kazuyahirotsu/LoRa/README.md

# LoRa
This repository is a collection of codes that I used for my thesis project.  
For more information, read [this documentation](https://docs.google.com/document/d/1nxEVbDSikG9Jm16irHsT5aI4RiOQiIEvlL14KSLo8pY/edit?usp=sharing)
