kazuyahirotsu/LoRa/project/README.md

## esp32

This folder contains ino files for esp32. 
you might need to add some libraries to use them on Arduino app

## GPS-visualization-Python

This folder contains python scripts for visualizing csv files of the tests with raspberrypi 

## izunuma_analysis

This folder contains codes for analysis of izunuma deployment

## matlab

This folder contains matlab scripts for simulating LoRa and mpsk

## network_simulation

This folder contains python scripts for simulating custom mac layer protocols

## raspberrypi

This folder contains python scripts for base node operation and test with raspberrypi

## relay

This folder contains python scripts for basic simulation of relay

## solar

This folder contains python scripts for testing a solar panel and a battery with raspberrypi

## weather

This folder contains python scripts for simulating battery life in certain place
