kazuyahirotsu/LoRa/project/GPS-visualization-Python/map/map0.png

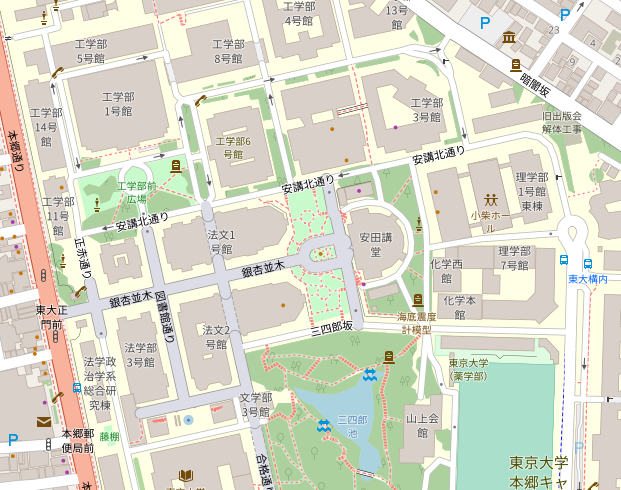
project/GPS-visualization-Python/map/map0.png
