kazuyahirotsu/LoRa/project/GPS-visualization-Python/map/map_big_izunuma.png

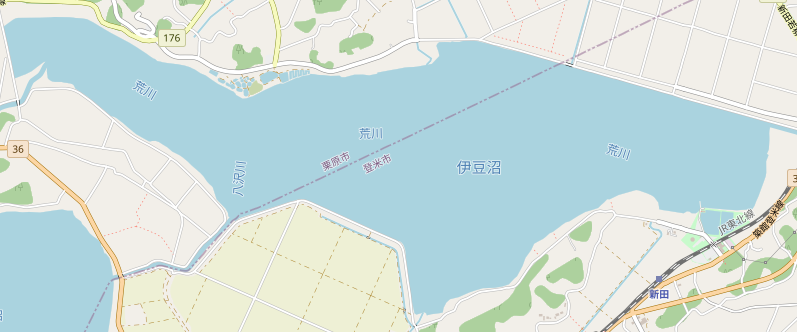
project/GPS-visualization-Python/map/map_big_izunuma.png
