kazuyahirotsu/LoRa/project/GPS-visualization-Python/map/map_small_izunuma.png

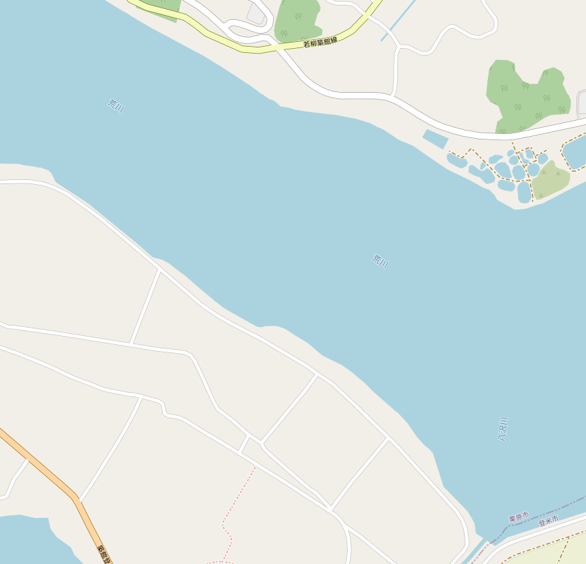
project/GPS-visualization-Python/map/map_small_izunuma.png
