kazuyahirotsu/LoRa/project/GPS-visualization-Python/map/map_toyosu.png

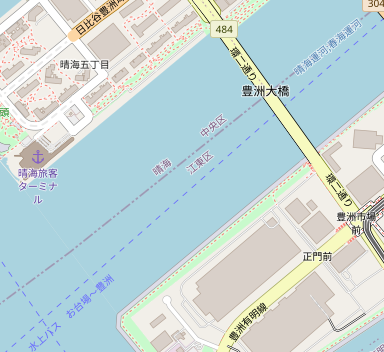
project/GPS-visualization-Python/map/map_toyosu.png
