kazuyahirotsu/LoRa/project/GPS-visualization-Python/output.png

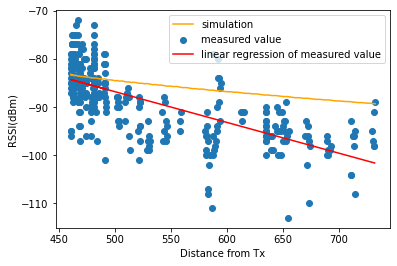
project/GPS-visualization-Python/output.png
