kazuyahirotsu/LoRa/project/GPS-visualization-Python/plot_small_izunuma.png

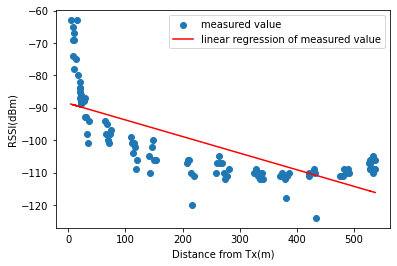
project/GPS-visualization-Python/plot_small_izunuma.png
