kazuyahirotsu/LoRa/project/matlab/LoRa/justnoise_ser_bigtest.png

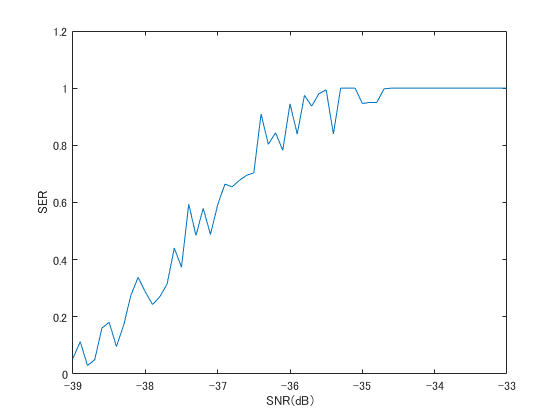
project/matlab/LoRa/justnoise_ser_bigtest.png
