kazuyahirotsu/LoRa/project/matlab/LoRa/multipath_ser_bigtest.png

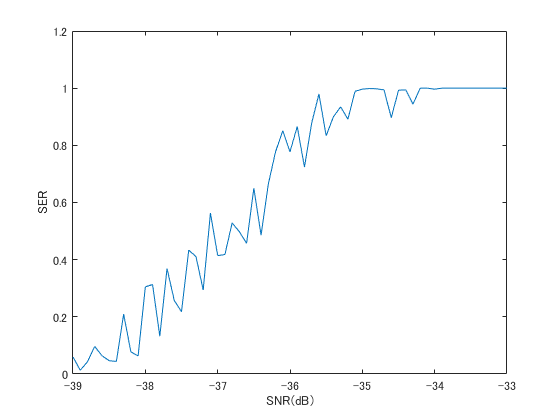
project/matlab/LoRa/multipath_ser_bigtest.png
