kazuyahirotsu/LoRa/project/matlab/psk/bpsk_ser_bigtest.png

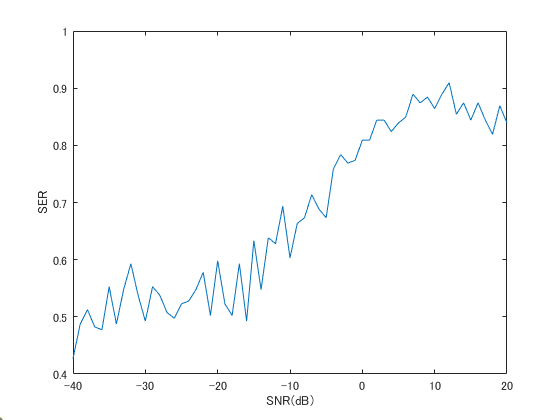
project/matlab/psk/bpsk_ser_bigtest.png
