kazuyahirotsu/LoRa/project/matlab/psk/qpsk_ser_bigtest.png

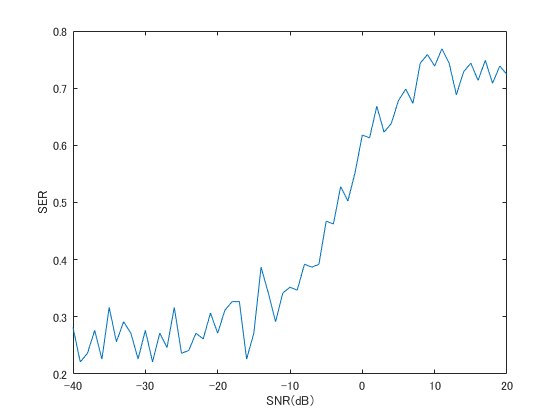
project/matlab/psk/qpsk_ser_bigtest.png
