kazuyahirotsu/LoRa/project/solar/output.png

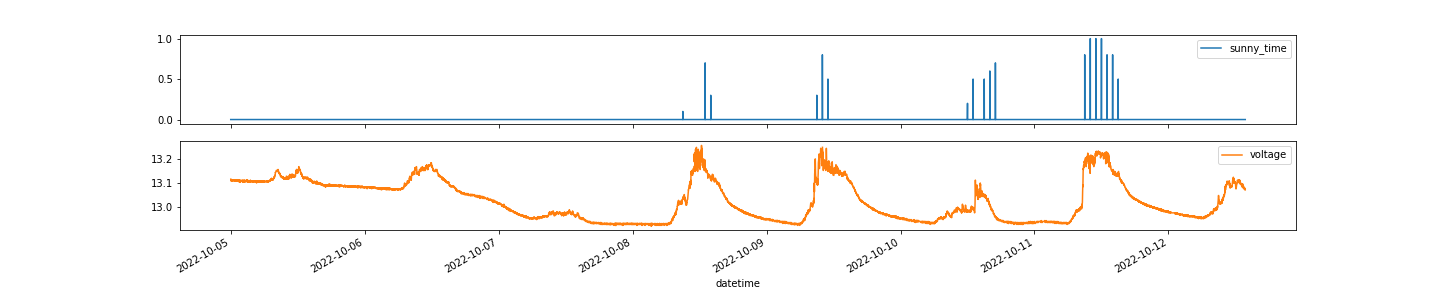
project/solar/output.png
