kazuyahirotsu/LoRa/project/weather/backtest.png

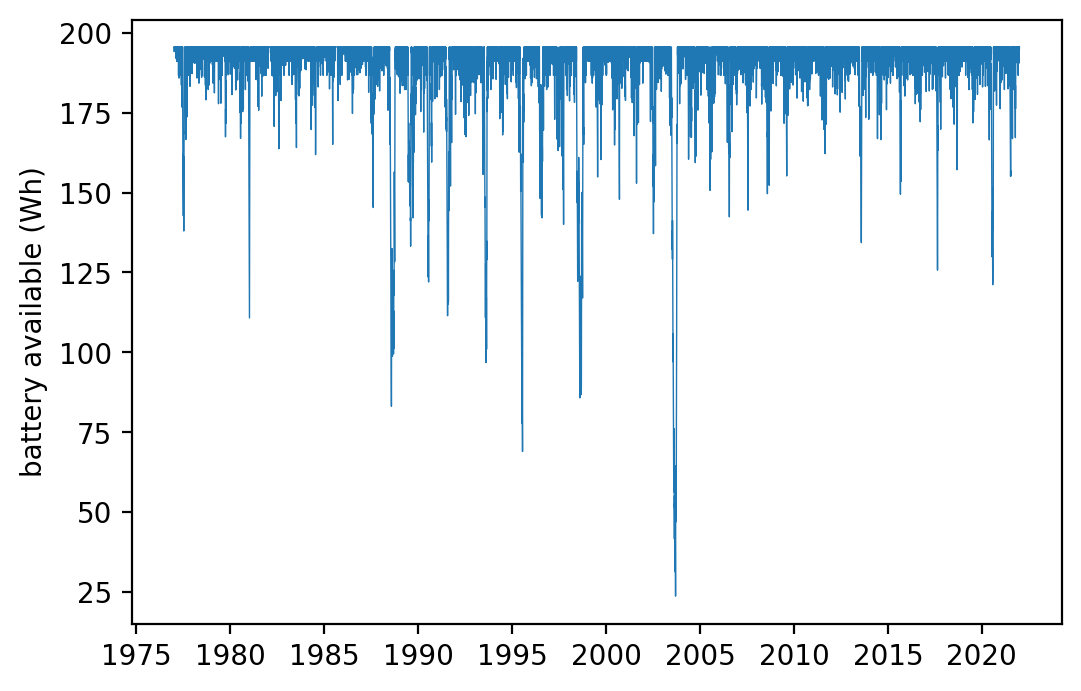
project/weather/backtest.png
