kazuyahirotsu/LoRa/project/weather/sunshine_duration.png

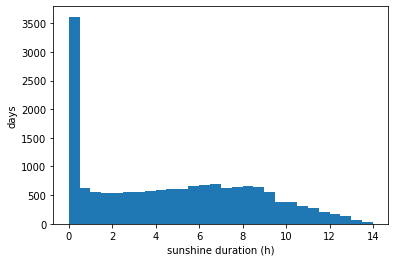
project/weather/sunshine_duration.png
