kazuyahirotsu/LoRa/project/GPS-visualization-Python/reslutMap/resultMap_5_10.png

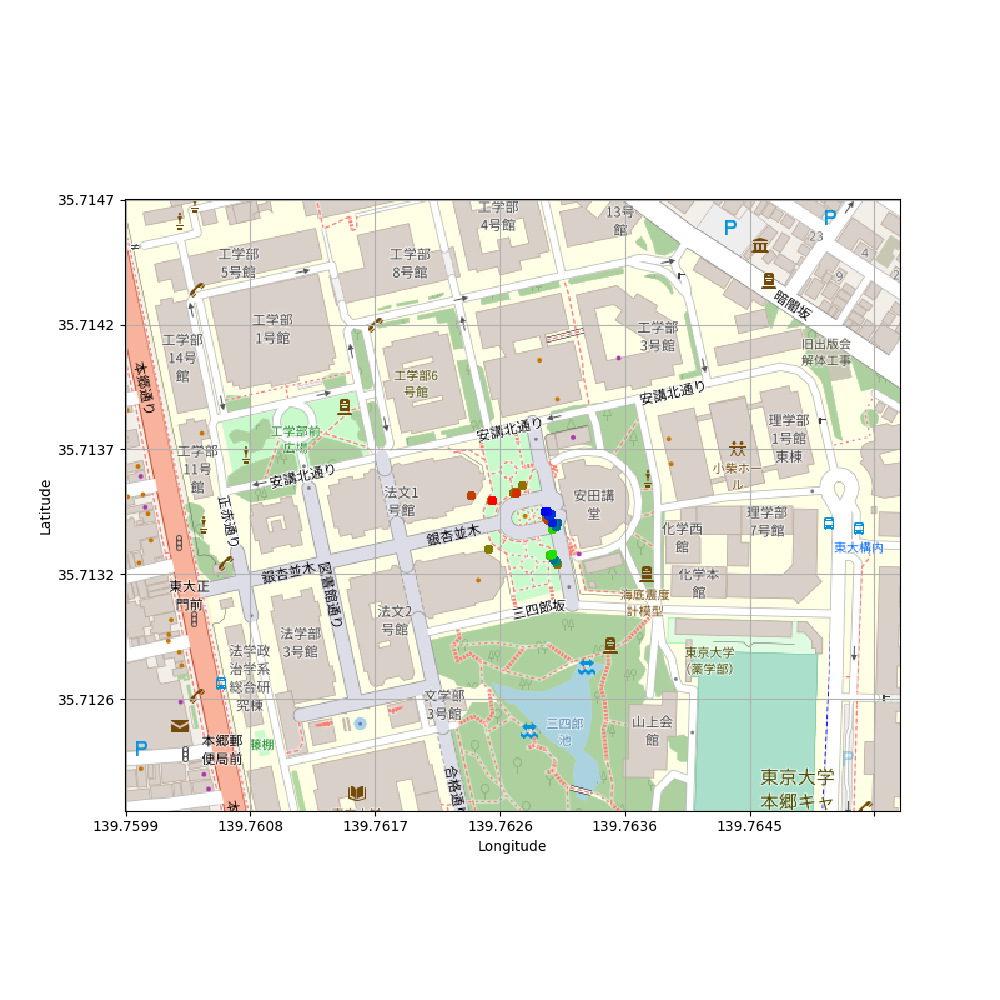
project/GPS-visualization-Python/reslutMap/resultMap_5_10.png
