kazuyahirotsu/LoRa/project/GPS-visualization-Python/reslutMap/resultMap_5_15.png

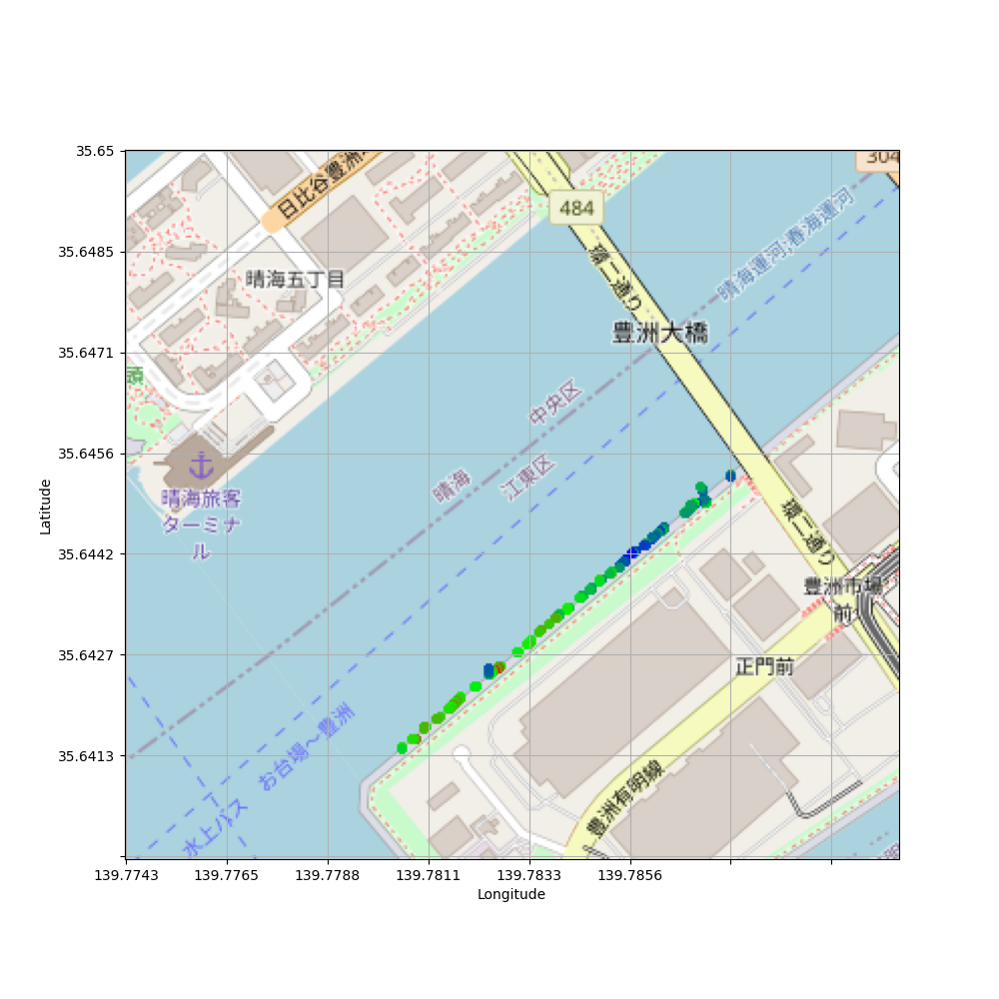
project/GPS-visualization-Python/reslutMap/resultMap_5_15.png
