kazuyahirotsu/LoRa/project/GPS-visualization-Python/reslutMap/resultMap_big_izunuma.png

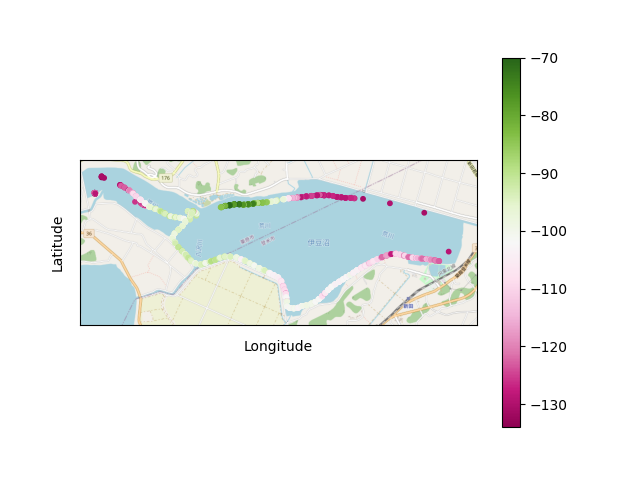
project/GPS-visualization-Python/reslutMap/resultMap_big_izunuma.png
