kazuyahirotsu/LoRa/project/GPS-visualization-Python/reslutMap/resultMap_small_izunuma.png

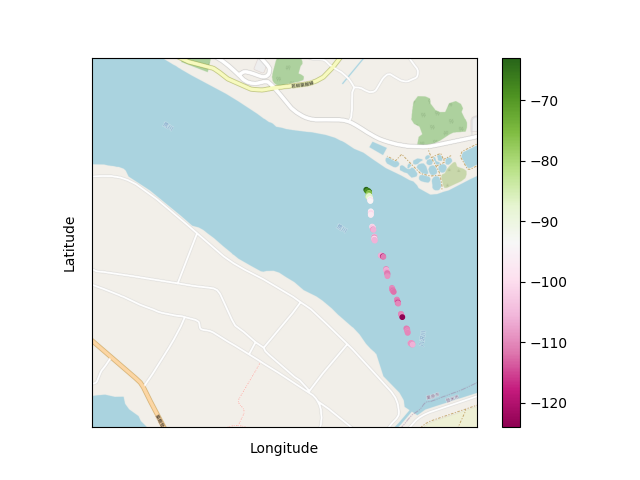
project/GPS-visualization-Python/reslutMap/resultMap_small_izunuma.png
