kazuyahirotsu/LoRa/project/GPS-visualization-Python/reslutMap/resultMap_toyosu.png

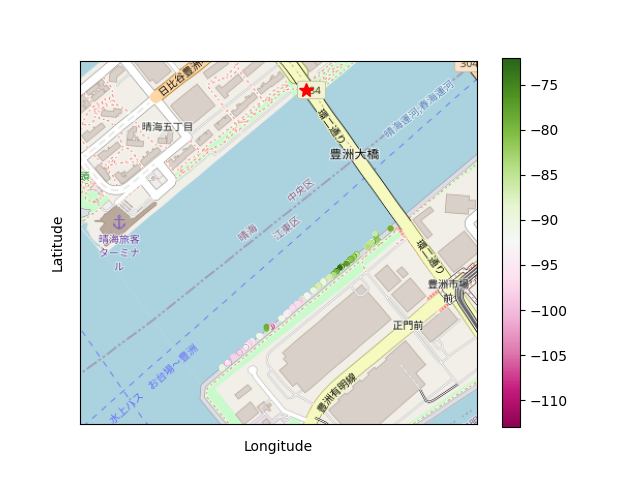
project/GPS-visualization-Python/reslutMap/resultMap_toyosu.png
