kazuyahirotsu/LoRa/project/izunuma_analysis/result0001.png

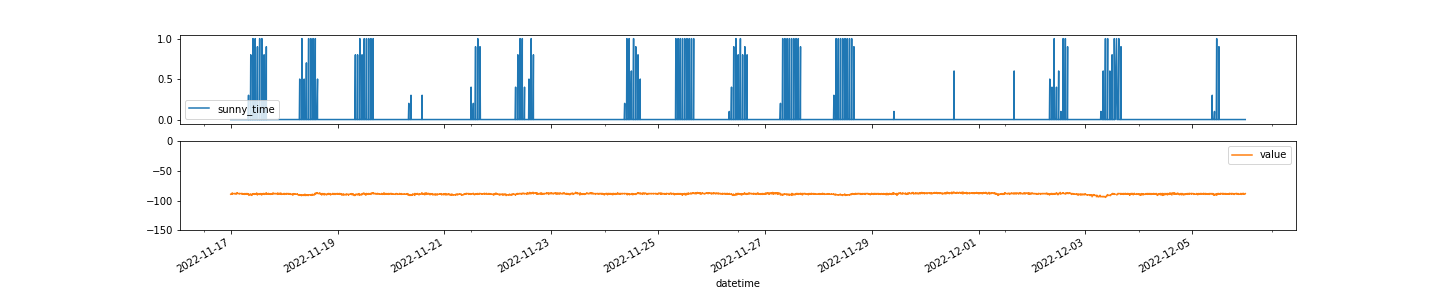
project/izunuma_analysis/result0001.png
