kazuyahirotsu/LoRa/project/izunuma_analysis/result0002.png

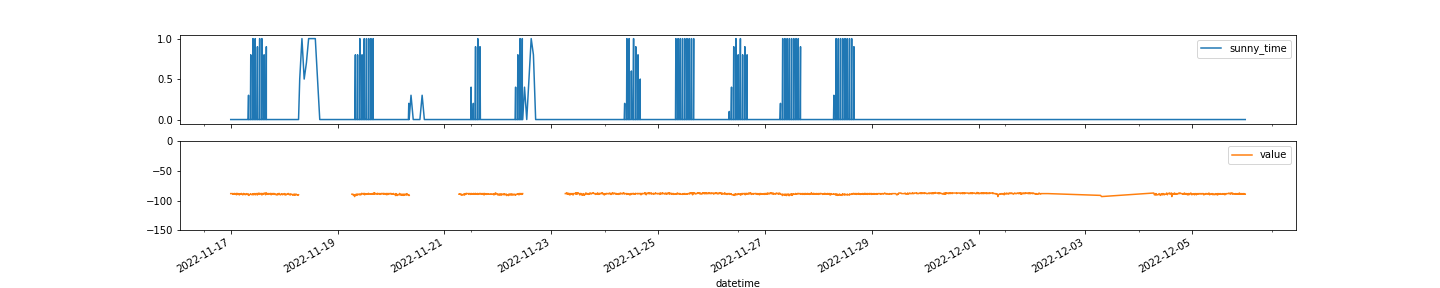
project/izunuma_analysis/result0002.png
