kazuyahirotsu/LoRa/project/izunuma_analysis/result0003.png

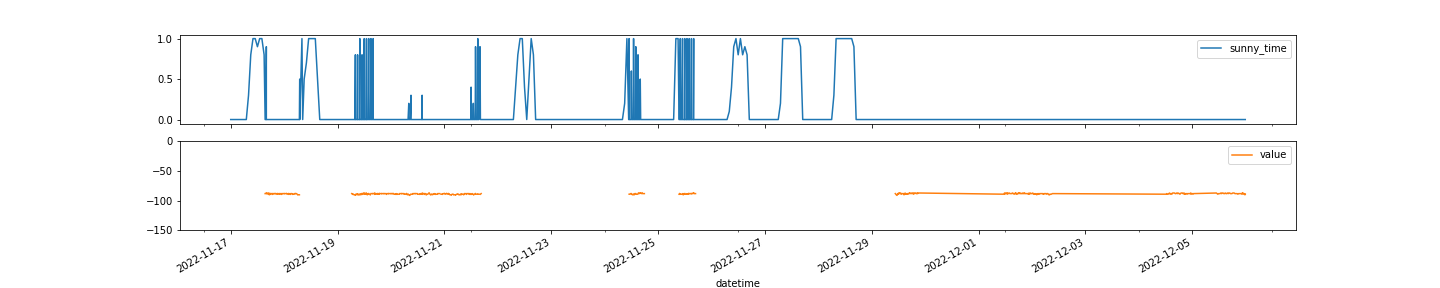
project/izunuma_analysis/result0003.png
