kazuyahirotsu/LoRa/project/matlab/LoRa/maintest.png

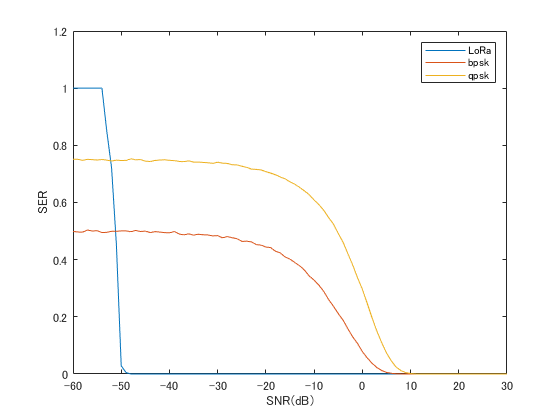
project/matlab/LoRa/maintest.png
