kazuyahirotsu/LoRa/(commit log)

2022-05-09 Fixed base.py and added scripts for sending gps
    [gps_ssh_setup.py, gps_test.py, read.py, send_gps_mac.py, setup_7067.py, setup_7068.py]
2022-05-11 Added visualization of the test
    [test_5_10.csv]
2022-05-11 Fixed submodule
    [data.csv]
2022-05-11 Added rangetest results folder
    [test_5_10.csv]
2022-05-12 Added virtualenv
    [data.csv, test_5_10.csv]
2022-05-16 Added toyosu testing results
    [data.csv, data_5_10.csv]
2022-06-16 Added more results and made rssi maps
    [data_6_16_2.csv, data_toyosu.csv, test_6_16.csv, test_6_16_2.csv]
2022-06-19 Added failed points to the result map
    [data_6_16.csv, test_6_16_id.csv]
2022-06-21 Organized folder
    [data_5_10.csv, data_6_16.csv, data_6_16_2.csv, data_toyosu.csv]
2022-07-08 Added weather data and analysis script
    [data.csv]
2022-07-08 Added backtest script for battery
    [data_1977_2021.csv, data_2021.csv]
2022-07-18 Fixed the data
    [data_1977_2021.csv]
2022-07-18 Added arduino scripts
2022-07-18 Fixed a bug for sending aquired data and changed the timing to set up the RTC
    [child_0002.ino, parent_0001.ino]
2022-07-24 Added collision sim for relay system
2022-08-03 Added voltage monitoring script for raspberry pi
2022-08-24 Added voltage2capacity script and data
    [battery_discharge.csv, data53835_20220803.csv]
2022-09-03 esp32 script update
2022-09-04 Added request algorithm for esp32 script
2022-09-05 tested do sensor and implimented in request algorithm code
2022-09-05 made a function to send command to DO sensor
2022-10-10 Updated esp scripts and solar panel evalation
    [ambient_10_4_to_9.csv, sunny_time_10_1_to_9.csv]
2022-10-12 update solar test result
    [ambient_10_4_to_12.csv, sunny_time_10_1_to_11.csv]
2022-10-26 Updated esp32 scripts
2022-10-28 Added test script to upload data to AWS timestream from raspberry pi
2022-11-02 Connected esp32 to raspberry pi, implimented simple request method without sleep
2022-11-03 Added 10m sleep to esp32 program, and call reset with raspberry pi script
    [0001_parent_two_do_temp_sleep.ino, 0002_child_two_do_temp_sleep.ino, 0003_child_two_do_temp_sleep.ino, esp32_to_aws.py, wakeup_rtc.ino]
2022-11-04 Added feature to send time from raspberry pi and fixed bug not being able to wakeup from plugging in and out
    [0001_parent_two_do_temp_sleep.ino, 0002_child_two_do_temp_sleep.ino, 0003_child_two_do_temp_sleep.ino, esp32_to_aws.py]
2022-11-06 Added relay to save energy
2022-11-11 Wait untill DO sensor is ready
2022-11-11 Added timeout for DO sensor
2022-11-12 Added error handling for raspberry pi
    [esp32_to_aws.py]
2022-11-12 Shortened the operation and deleted unnecessary lines
    [0001_parent_two_do_temp_sleep.ino, 0002_child_two_do_temp_sleep.ino, 0003_child_two_do_temp_sleep.ino]
2022-11-20 Added temperature adjustment for DO sensor and changed analogRead to read more accurate value
2022-11-29 Added data analysis of izunuma deployment
    [0001_DO_1-data-2022-11-29 17_30_22.csv, 0001_RSSI-data-2022-11-29 17_50_45.csv, 0002_DO_1-data-2022-11-29 17_30_37.csv, 0002_RSSI-data-2022-11-29 17_51_08.csv, 0003_DO_1-data-2022-11-29 17_31_49.csv, 0003_RSSI-data-2022-11-29 17_51_21.csv, sunny_time_11_16_to_28.csv]
2022-11-29 Show all nine data, need to fix y axis range
2022-12-09 Fixed DO sensor timeout bug
2023-04-12 Update esp32 codes on board
2023-04-12 Added packet loss test raw results
    [-0dBm.csv, -0dBm_power_13.csv, -0dBm_power_8.csv, -100dBm.csv, -10dBm.csv, -20dBm.csv, -30dBm.csv, -60dBm.csv]
2023-04-12 Added analysis code on izunuma deployment
    [0001_RSSI-data-2022-12-01 01_26_30.csv, 0001_RSSI-data-2022-12-06 15_39_29.csv, 0002_RSSI-data-2022-12-01 01_26_52.csv, 0002_RSSI-data-2022-12-06 15_39_37.csv, 0003_RSSI-data-2022-12-01 01_26_59.csv, 0003_RSSI-data-2022-12-06 15_39_43.csv, energy_end.csv, energy_end2.csv]
2023-04-12 Added code for relay simulation
2023-04-12 Added energy consumption data
    [Graph4_22-11-14 14-27.csv, Graph5_22-11-14 14-48.csv]
2023-04-12 Clean up
    [-0dBm.csv, -0dBm_power_13.csv, -0dBm_power_8.csv, -100dBm.csv, -10dBm.csv, -20dBm.csv, -30dBm.csv, -60dBm.csv]
2023-04-12 Added esp32 codes for deployment
2023-04-12 Added esp32 deployment code
